Roxxannia/Analog-Digital-Circuit-Design-Project/(list of files, drawings)

Other design files:
DesignProject_wangs302.ms14
